MarconeAugusto/jiga-poe/Fotos/JIGA_PoE.jpg

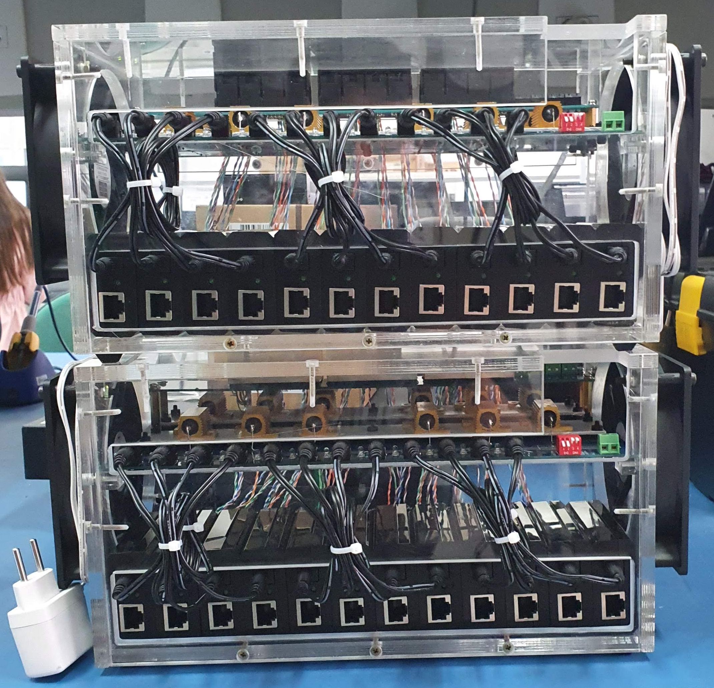
Fotos/JIGA_PoE.jpg
