MarconeAugusto/jiga-poe/Fotos/JIGA_PoE_01.jpg

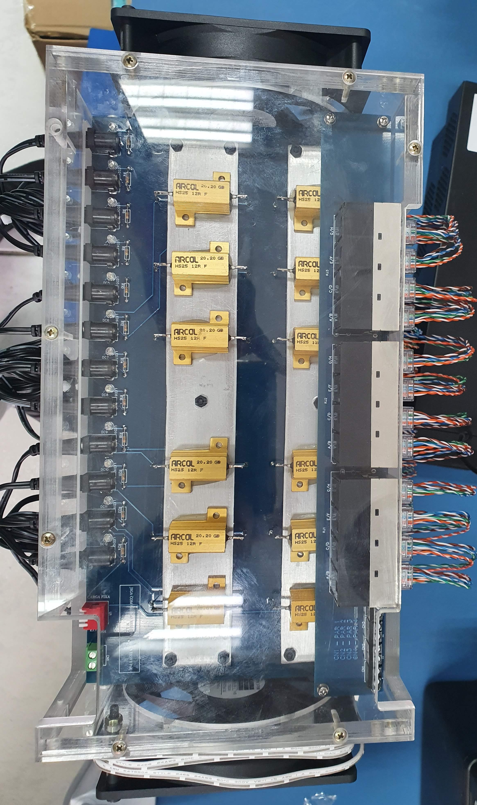
Fotos/JIGA_PoE_01.jpg
