MarconeAugusto/jiga-poe/Fotos/JIGA_PoE_04.jpg

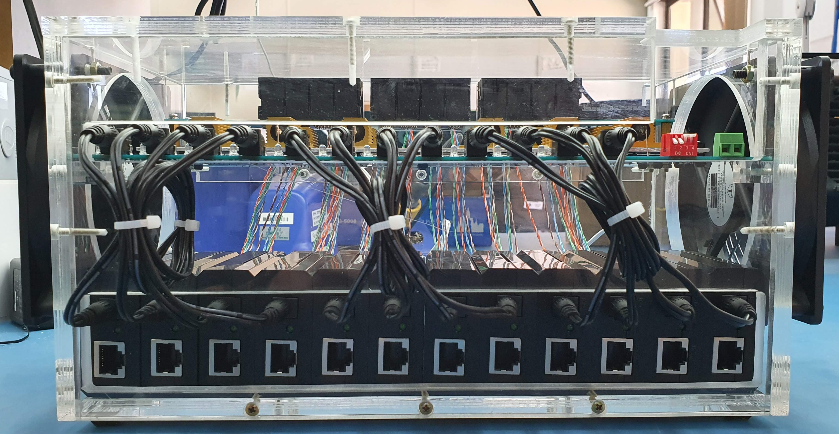
Fotos/JIGA_PoE_04.jpg
