MarconeAugusto/jiga-poe/Fotos/JIGA_PoE_05.jpg

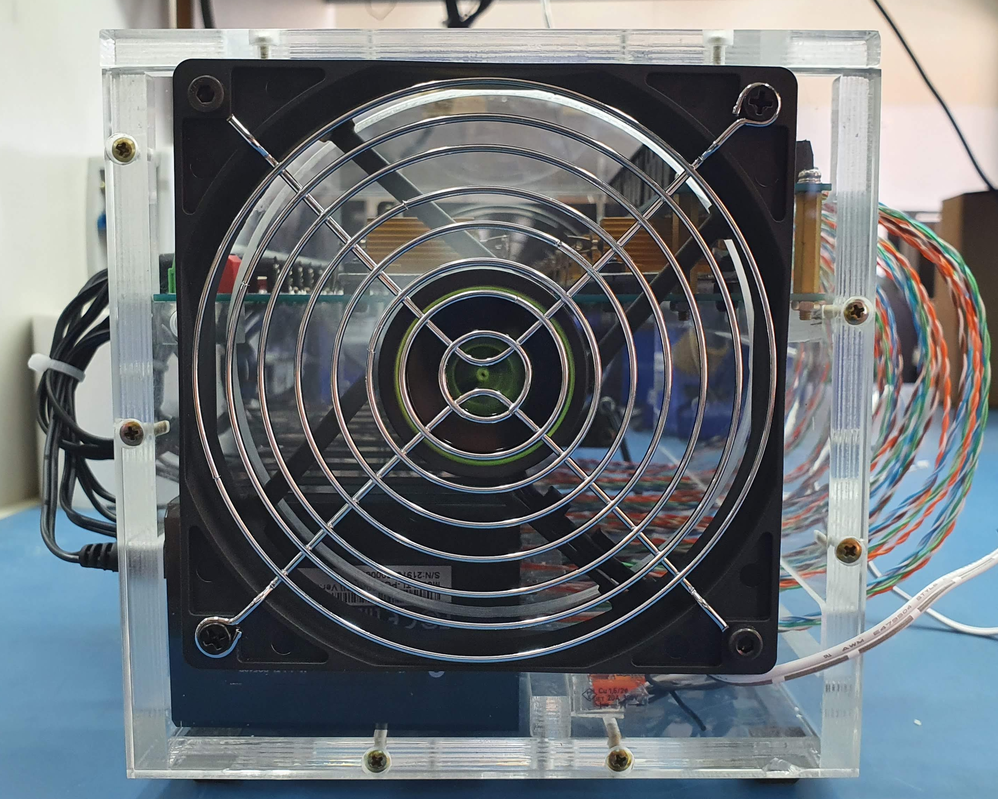
Fotos/JIGA_PoE_05.jpg
