MarconeAugusto/jiga-poe/Fotos/JIGA_PoE_09.jpg

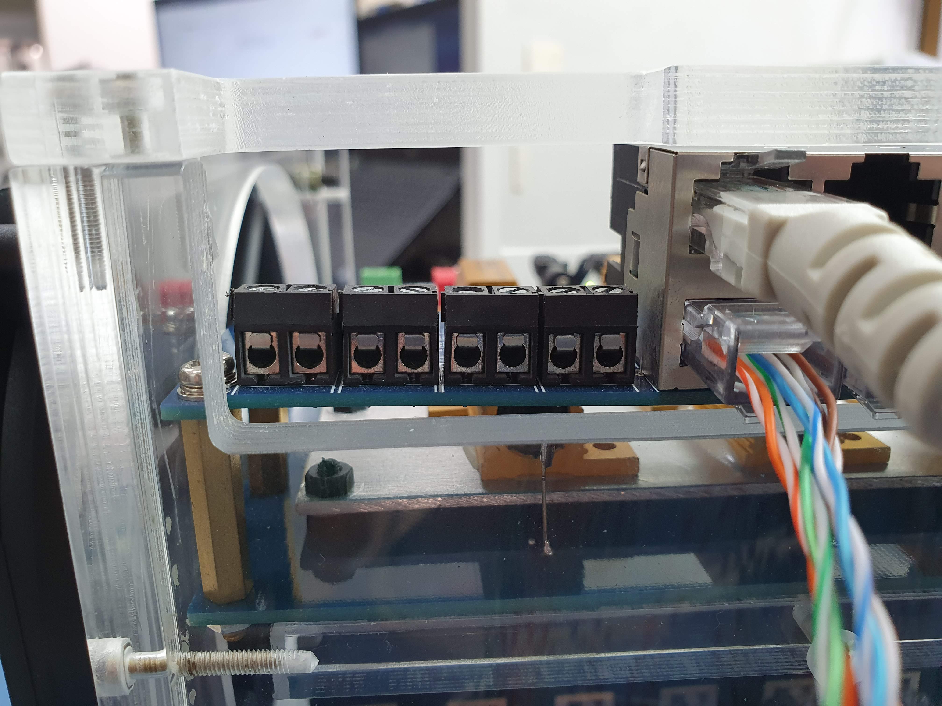
Fotos/JIGA_PoE_09.jpg
