MarconeAugusto/jiga-poe/Fotos/JIGA_PoE_11.jpg

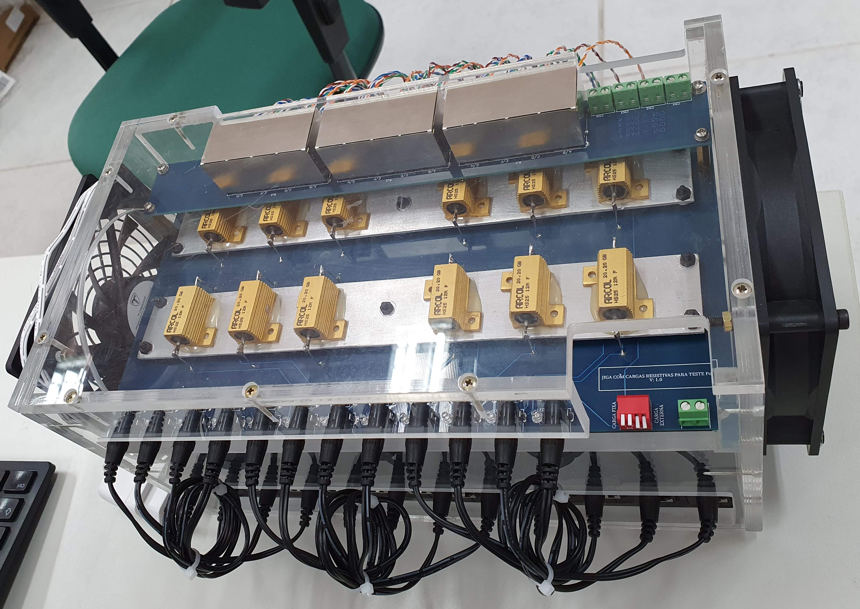
Fotos/JIGA_PoE_11.jpg
