MarconeAugusto/jiga-poe/Fotos/JIGA_PoE_14.jpg

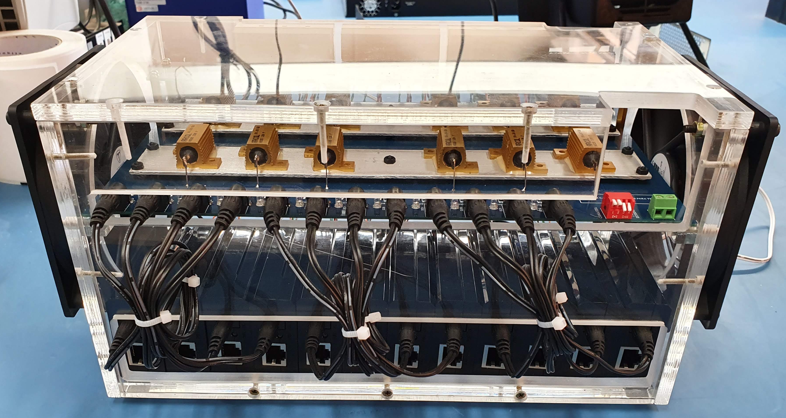
Fotos/JIGA_PoE_14.jpg
