MarconeAugusto/jiga-poe/PCB Cargas/3D_Cargas.png

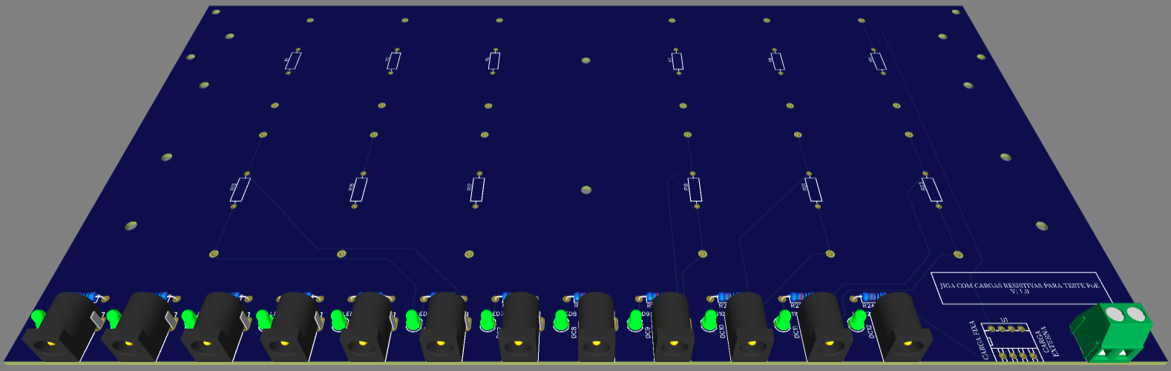
PCB Cargas/3D_Cargas.png
