MarconeAugusto/jiga-poe/PCB RJ45/3D_RJ45.png

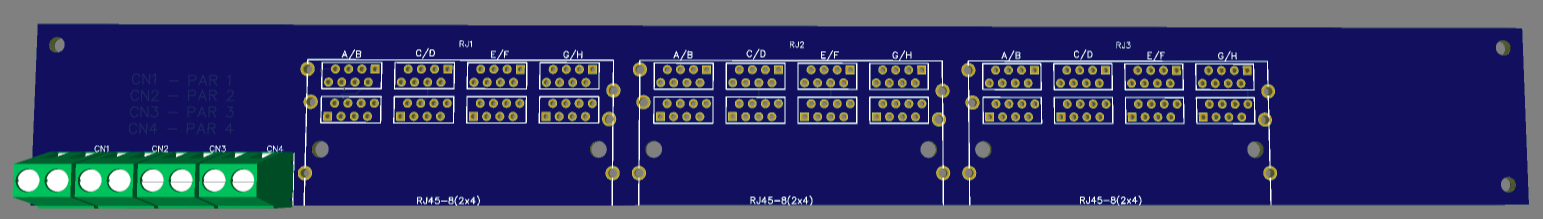
PCB RJ45/3D_RJ45.png
