MarconeAugusto/jiga-poe/PCB Cargas/BOM_PCB_V1.0_2021-05-24.csv

ID | Name | Designator | Footprint | Quantity | Manufacturer Part | Manufacturer | Supplier | Supplier Part | Price
1 | MKDSN1.5/2-5.08 | CN1 | CONN-TH_2P-P5.08_1714984 | 1
2 | DC-005 5.5-2.0MM | DC1,DC2,DC3,DC4,DC5,DC6,DC7,DC8,DC9,DC10,DC11,DC12 | DC-IN-TH_DC-5520 | 12
3 | HL-304S9AD | LED1,LED2,LED3,LED4,LED5,LED6,LED7,LED8,LED9,LED10,LED11,LED12 | LED-TH_BD3.0-P2.54-FD | 12
4 | 820 | R1,R3,R5,R7,R9,R11,R13,R15,R17,R19,R21,R23 | RES-TH_BD3.3-L9.0-P13.00-D0.6 | 12
5 | 1K | R2,R4,R6,R8,R10,R12,R14,R16,R18,R20,R22,R24 | RES-TH_BD2.3-L6.5-P10.50-D0.5 | 12
6 | VPG1S-04H-R_C3657 | U1 | SW-TH_VPG1S-04H-R | 1
