MarconeAugusto/jiga-poe/PCB RJ45/BOM_PCB_V1.0_RJ45_2021-05-24.csv

ID | Name | Designator | Footprint | Quantity | Manufacturer Part | Manufacturer | Supplier | Supplier Part | Price
1 | MKDSN1.5/2-5.08 | CN1,CN2,CN3,CN4 | CONN-TH_2P-P5.08_1714984 | 4
2 | DS1131-S80BP | RJ1,RJ2,RJ3 | RJ45-TH_DS1131-S80BP | 3
