MarconeAugusto/jiga-poe/(list of files, cad)

Other CAD files:
Projeto Acrilico/JIGA_TAMPA.psm
