MarconeAugusto/jiga-poe/PCB Cargas/Schematic_JIGA_PoE_V2_2021-05-24.pdf

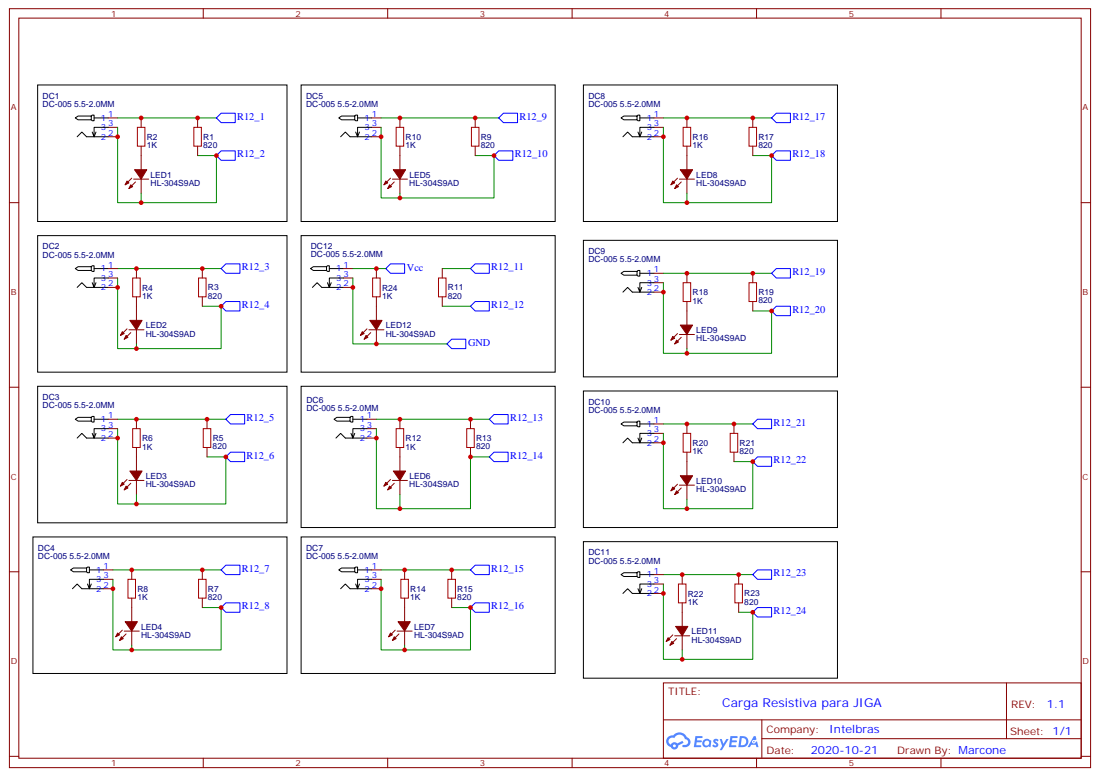
[picture p23: page 1]
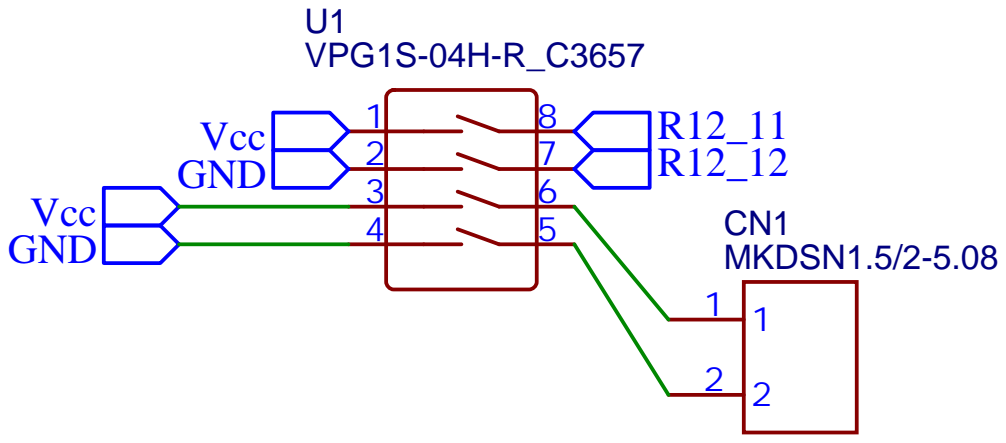
[picture p24: page 2]
