MarconeAugusto/jiga-poe/PCB RJ45/Schematic_JIGA_PoE_RJ45_2021-05-24.pdf

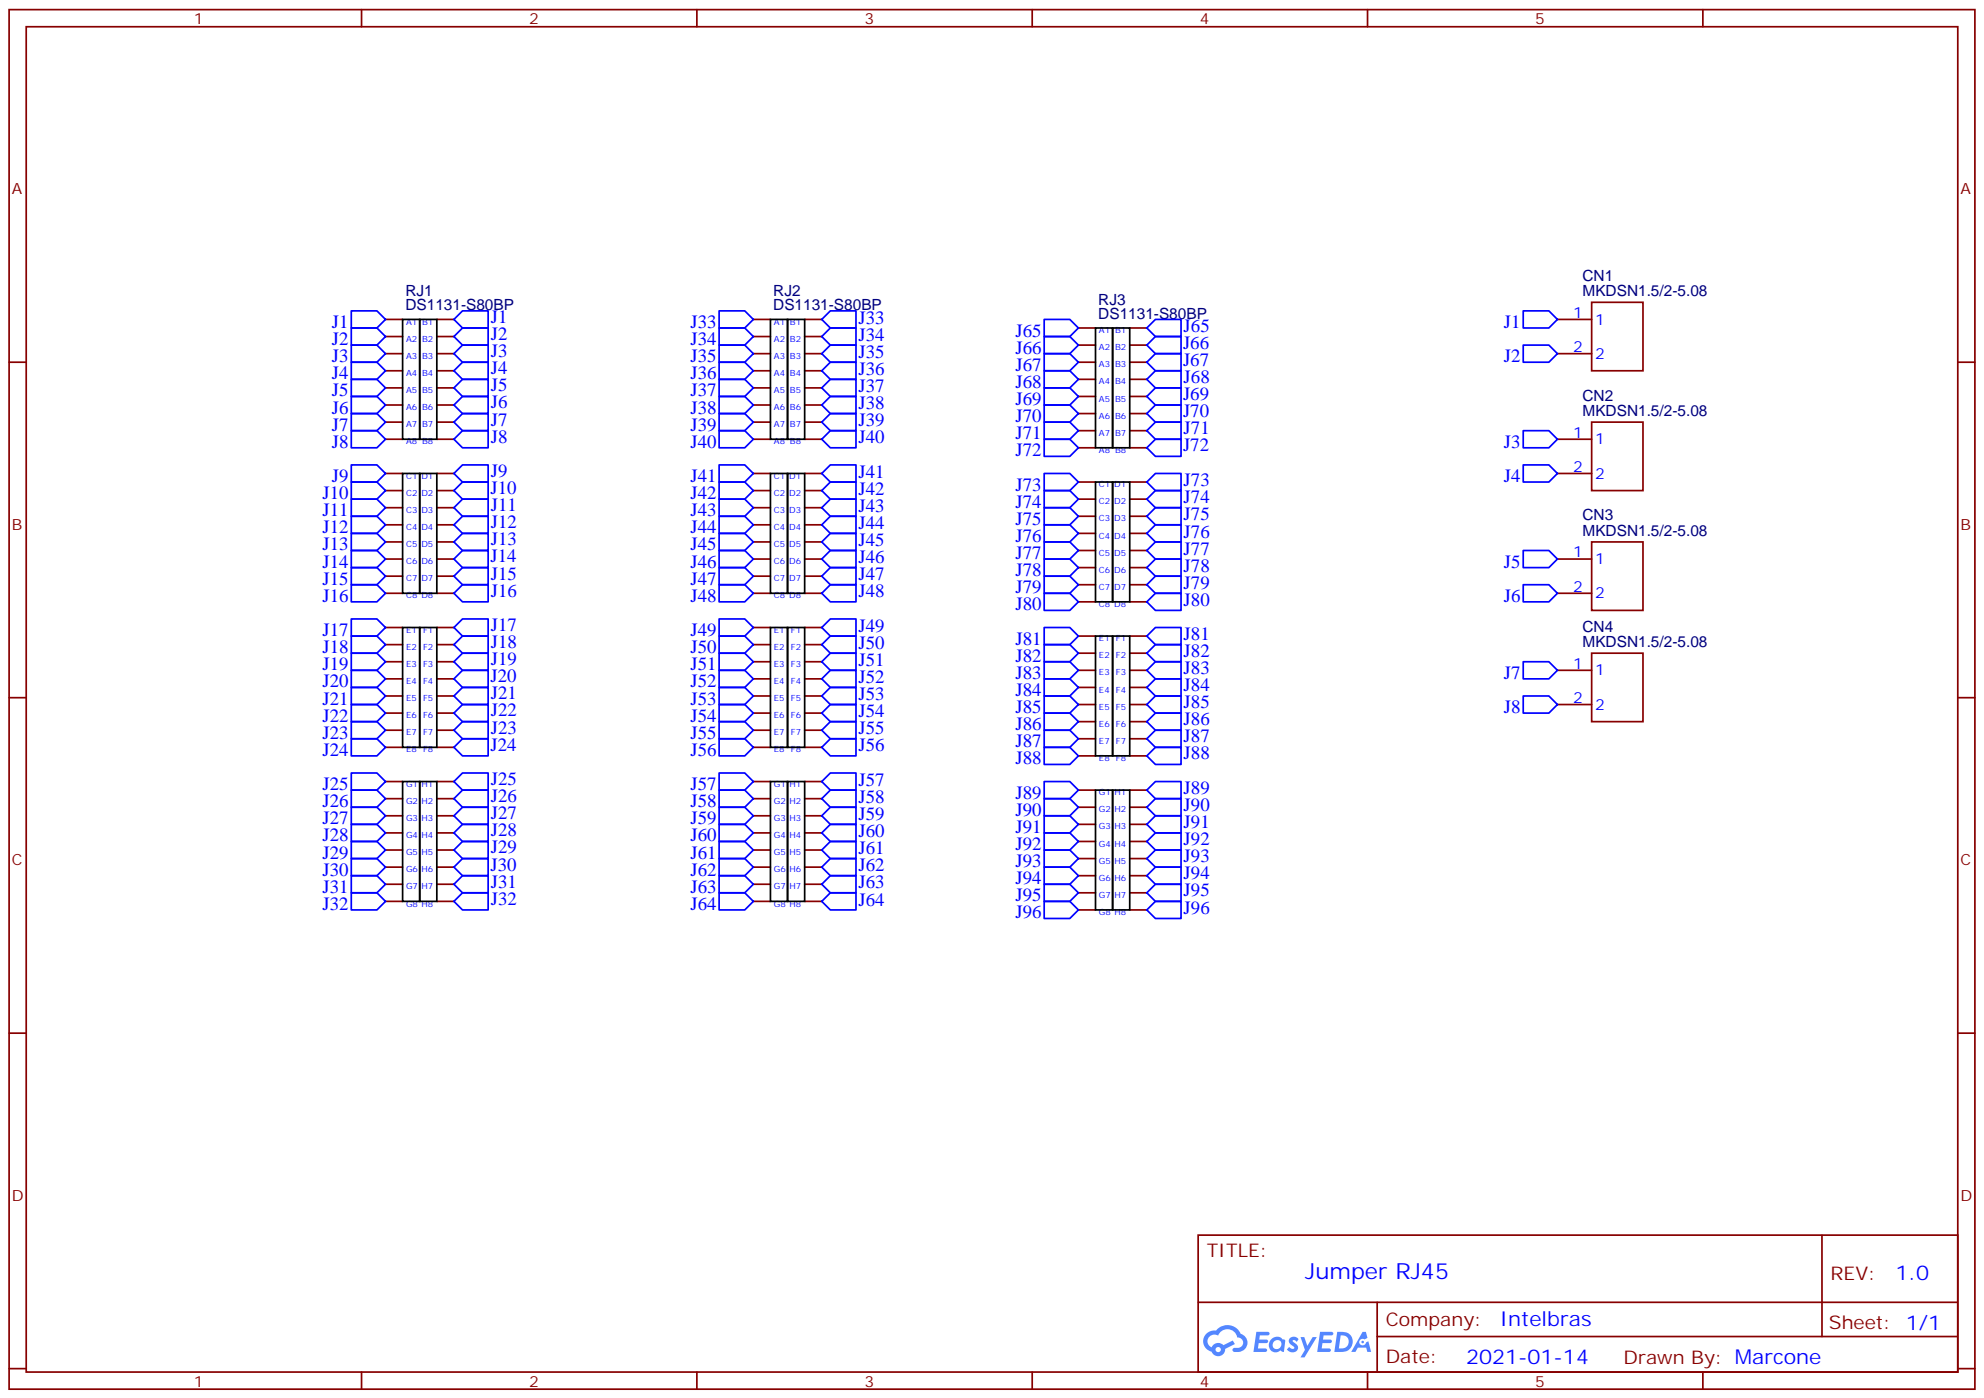
[picture p25: page 1]
