MarconeAugusto/jiga-poe/PCB Cargas/PCB_PCB_V1.0_2021-05-24.pdf

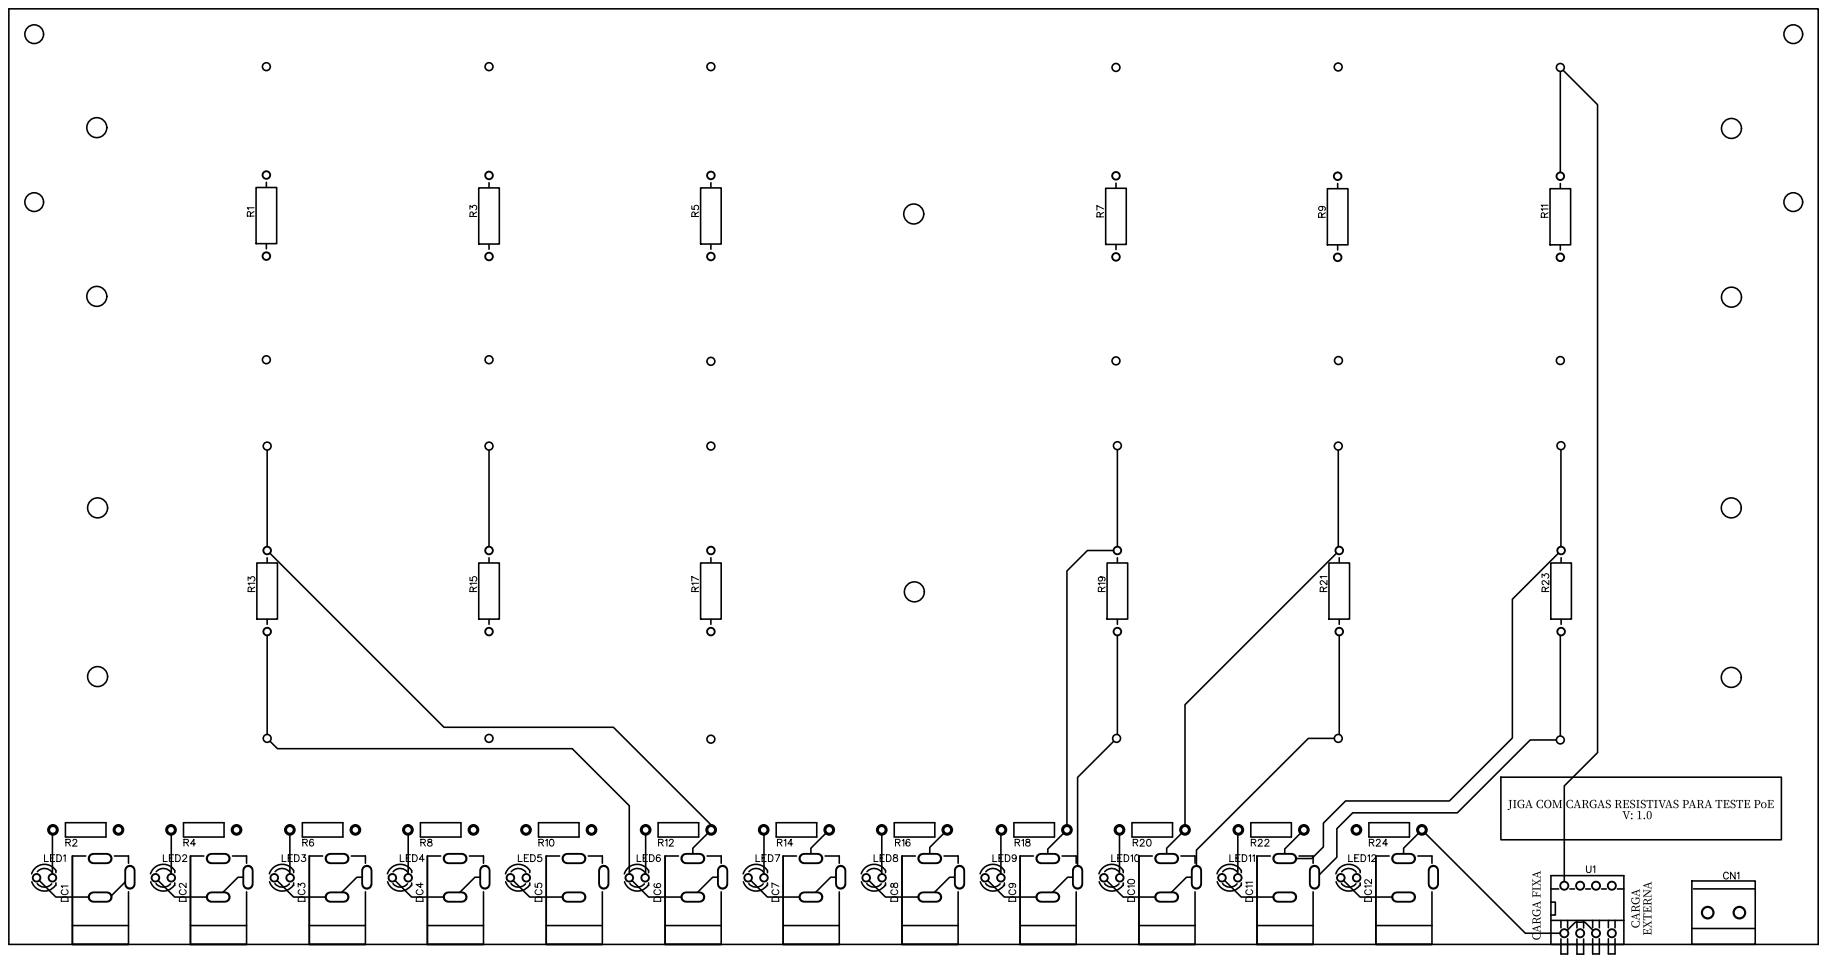
[picture p26: page 1]
