MarconeAugusto/jiga-poe/PCB RJ45/PCB_PCB_V1.0_RJ45_2021-05-24.pdf

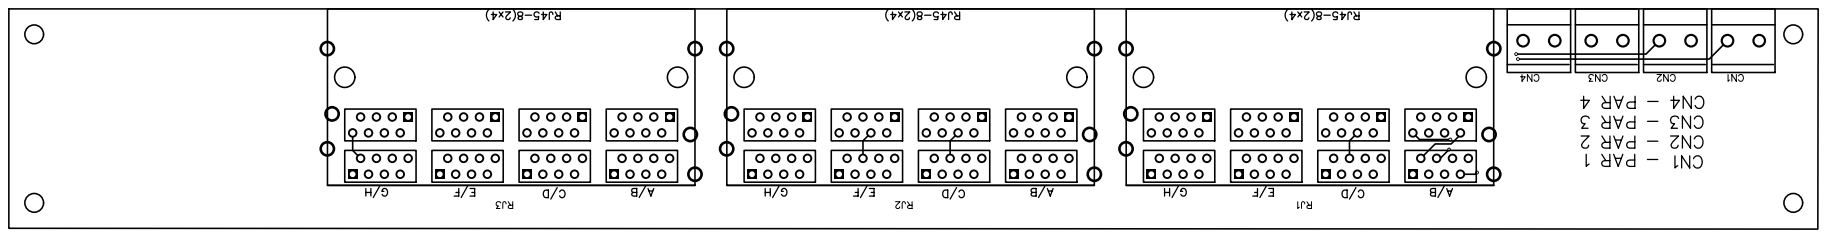
[picture p27: page 1]
