MarconeAugusto/jiga-poe/Draw/Draw_Base.pdf

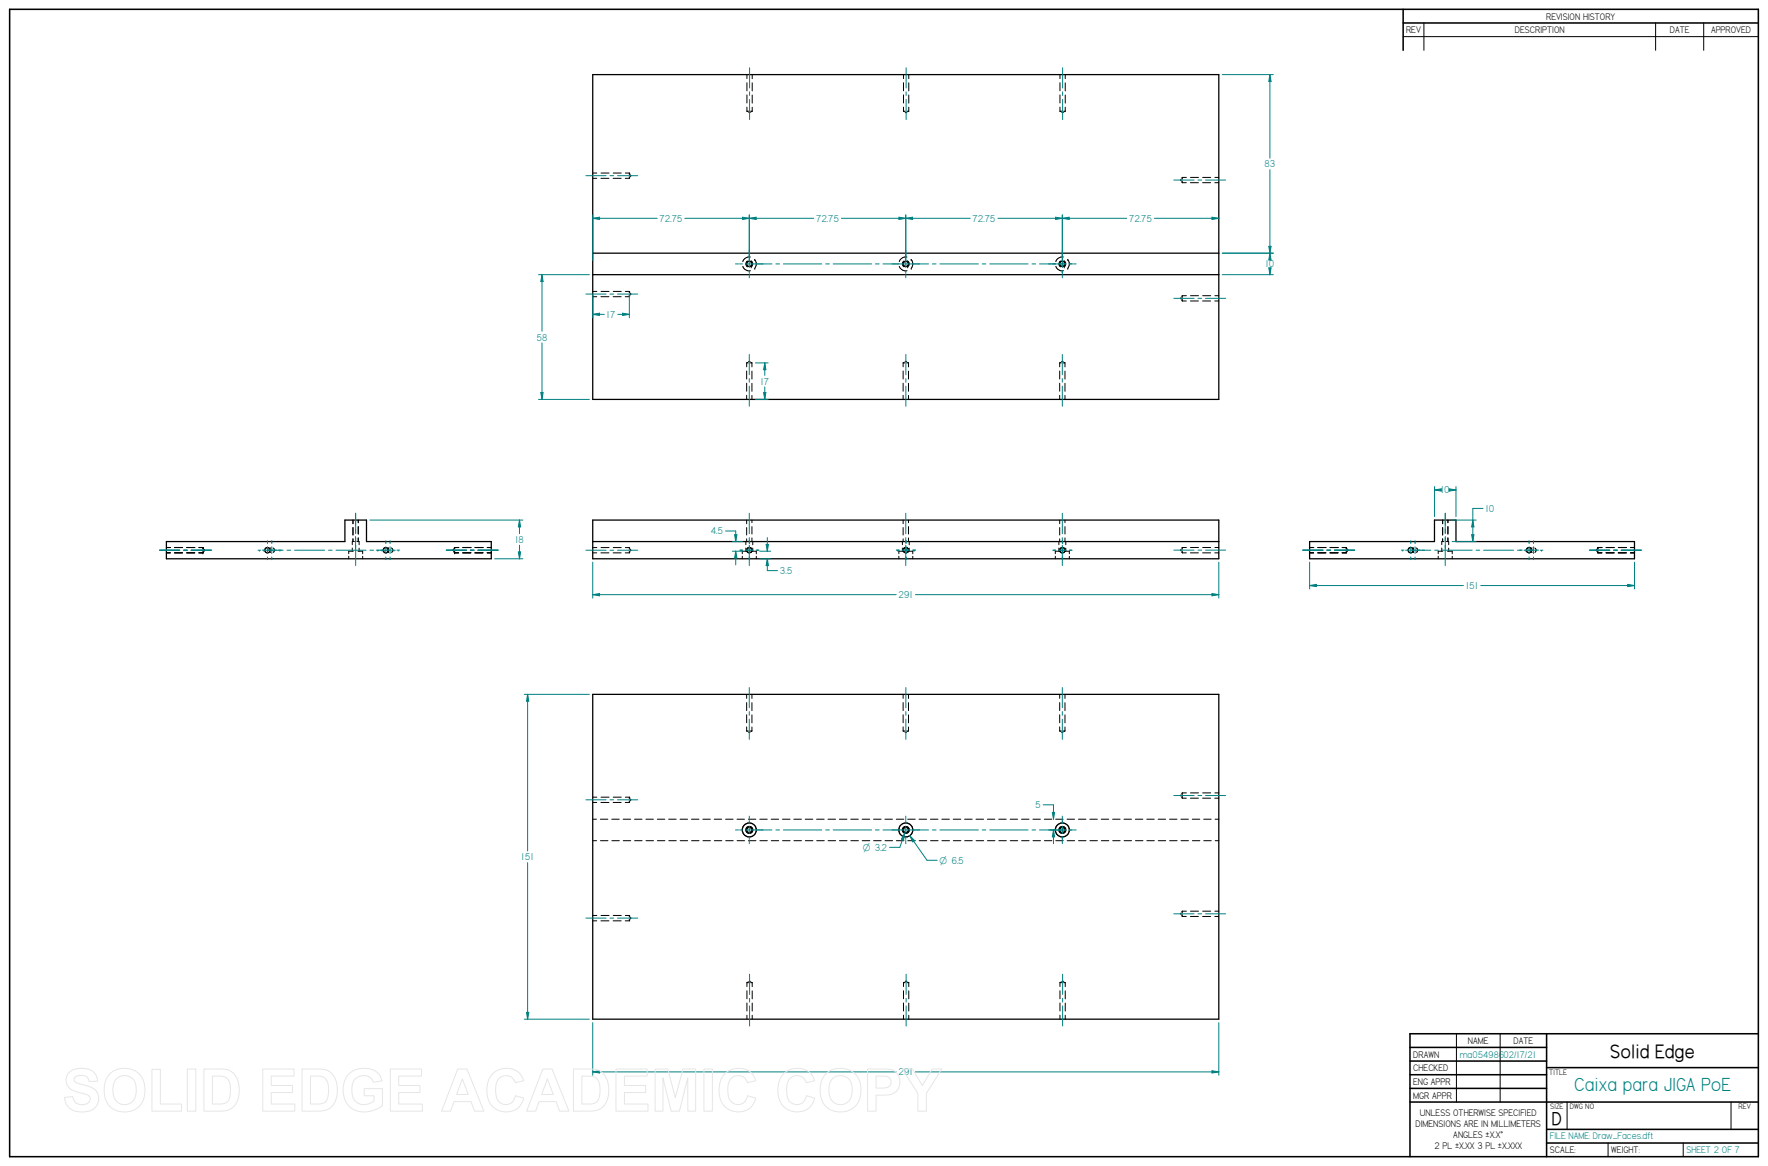
[picture p22: page 1]
SCALE:; WEIGHT:; SHEET 2 OF 7

REVISION HISTORY

REV | DESCRIPTION | DATE | APPROVED

NAME | DATE 02/17/21 | Solid Edge

DRAWN | ma054986
CHECKED
ENG APPR
MGR APPR
UNLESS OTHERWISE SPECIFIED DIMENSIONS ARE IN MILLIMETERS ANGLES ±X.X° 2 PL ±X.XX 3 PL ±X.XXX | SIZE D | DWG NO | REV

TITLE
Caixa para JIGA PoE

FILE NAME: Draw_Faces.dft
